marianoelia/flip-dot/3DCase/4.5mmAcrylic/Decals/FlipDotBack.png

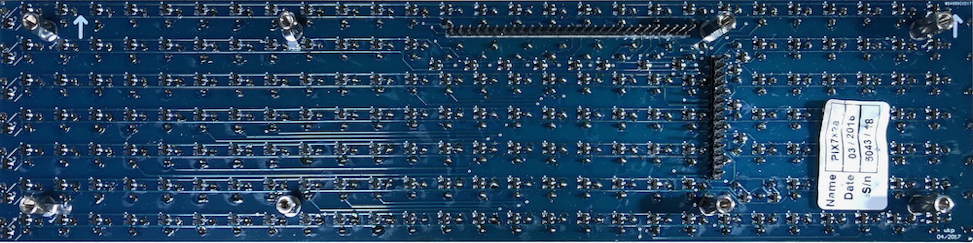
3DCase/4.5mmAcrylic/Decals/FlipDotBack.png
