marianoelia/flip-dot/3DCase/4.5mmAcrylic/Decals/PhotonTop.png

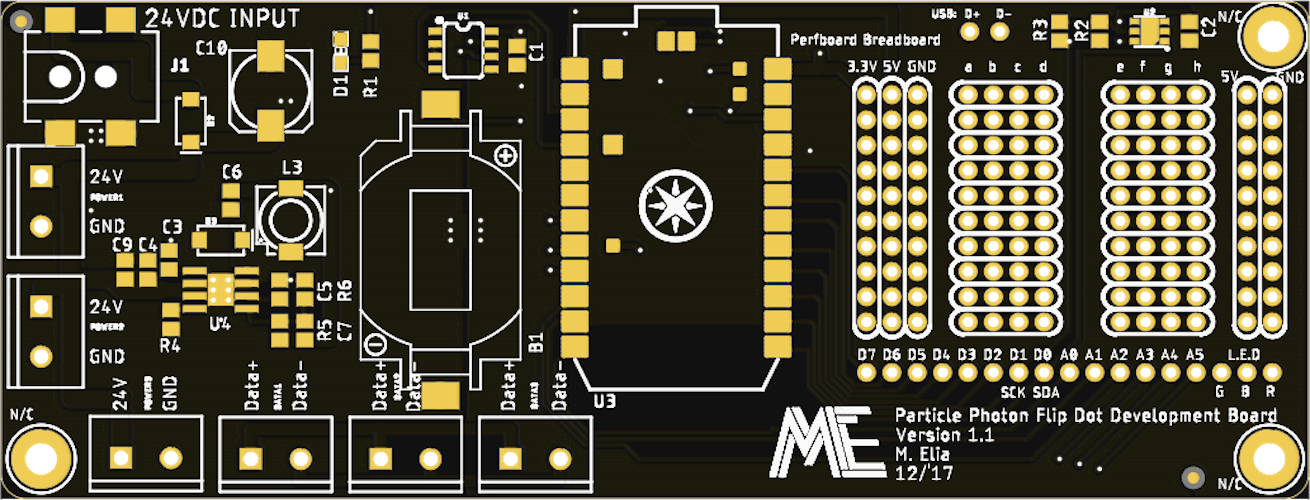
3DCase/4.5mmAcrylic/Decals/PhotonTop.png
