marianoelia/flip-dot/README.md

# Flip Dot Clock
All files for used for my flip dot display. Powered by the Particle Photon.

FlipDot
