marianoelia/flip-dot/3DCase/4.5mmAcrylic/Decals/ControllerBoard.jpg

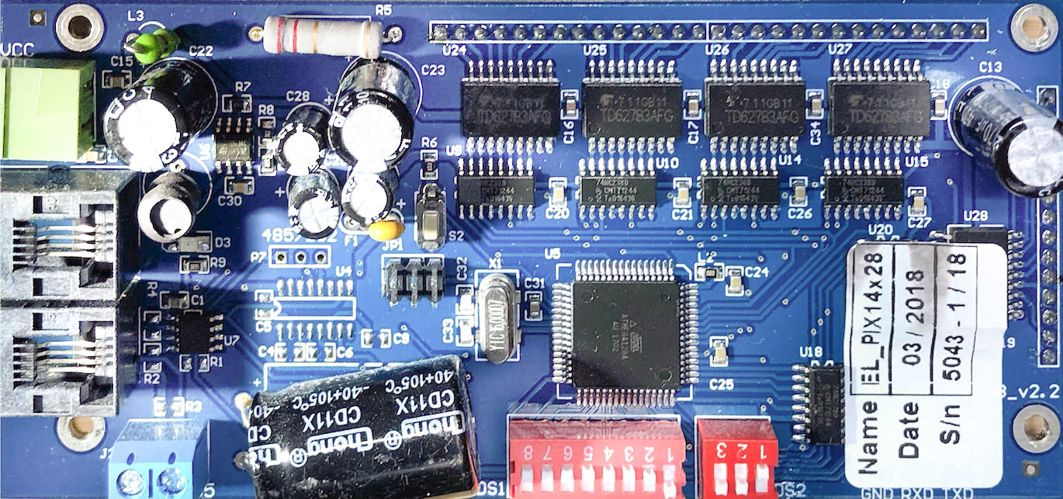
3DCase/4.5mmAcrylic/Decals/ControllerBoard.jpg
