marianoelia/flip-dot/3DCase/4.5mmAcrylic/Decals/PhotonBottom.png

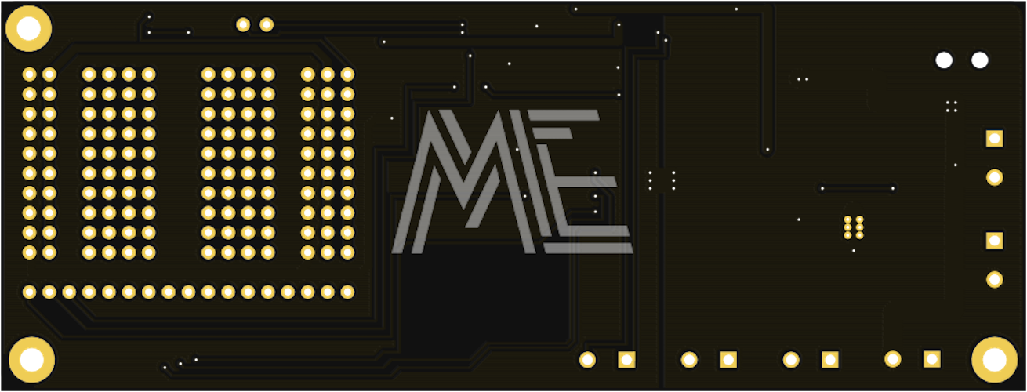
3DCase/4.5mmAcrylic/Decals/PhotonBottom.png
