marianoelia/flip-dot/3DCase/SinglePiece/SinglePieceAssembly.SLDASM

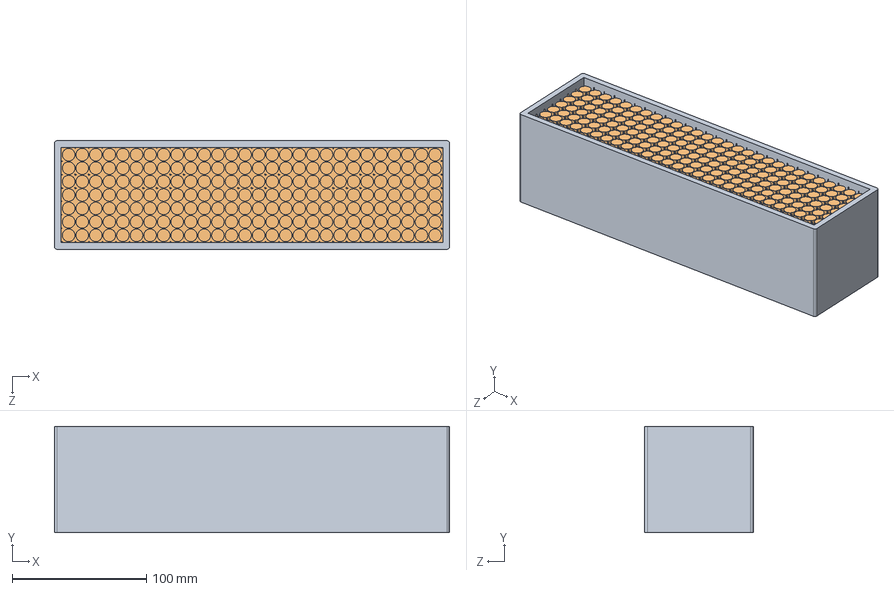
[picture p5: CAD file, 2018-06-12]
3DCase/SinglePiece/SinglePieceAssembly.SLDASM
294.0 x 79.0 x 81.0 mm
Case
Panel
