marianoelia/flip-dot/3DCase/4.5mmAcrylic/CaseAssembly4.5mm.SLDASM

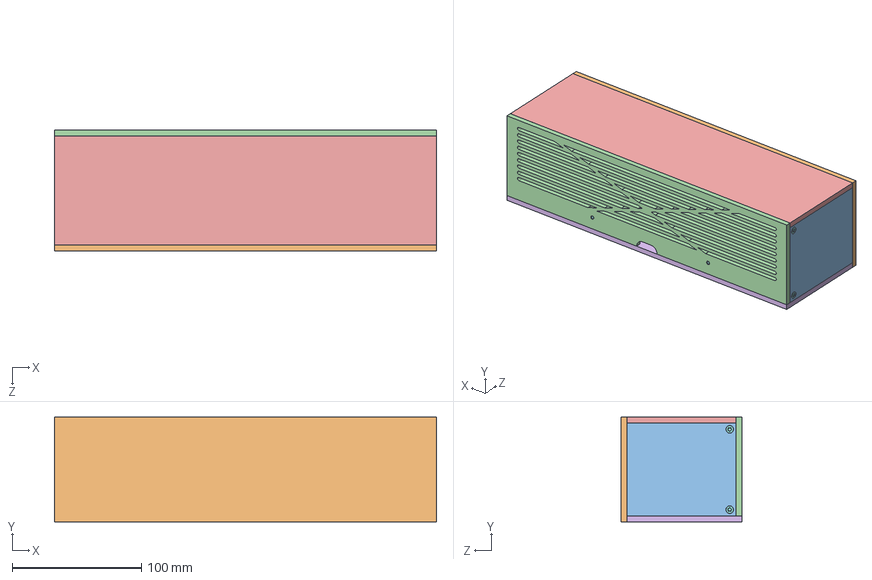
[picture p6: CAD file, 2018-11-08]
3DCase/4.5mmAcrylic/CaseAssembly4.5mm.SLDASM
295.0 x 81.0 x 93.5 mm
Panel4.5mm
FrontSide4.5mm
leftRightSides4.5mm x 2
BackSide4.5mm
TopSide4.5mm
BottomSide4.5mm
5.3mmHeatInsert x 4
M3HexScrew x 6
FlipDotControllerBoard
15mmHexStandoff x 2
PhotonPCB
20mmHexStandoff x 2
GluedInsetBlock4mm x 4
