marianoelia/flip-dot/3DCase/4.5mmAcrylic/AllPartsForLaserCutting.SLDASM

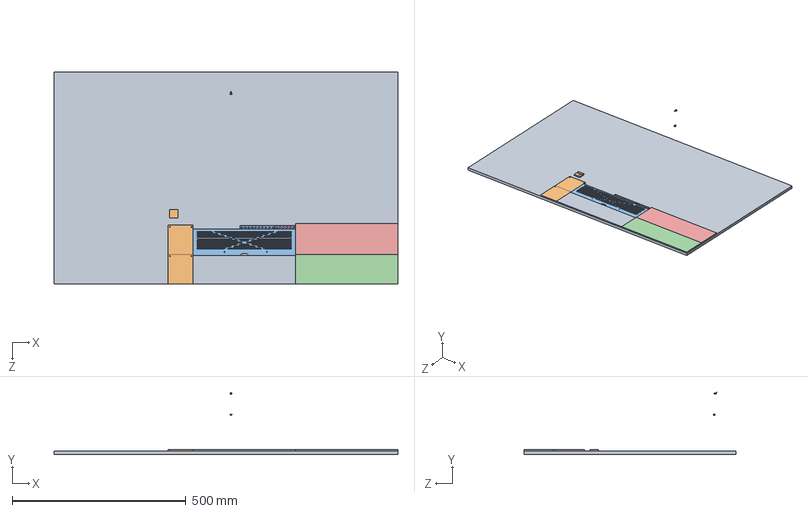
[picture p7: CAD file, 2018-11-08]
3DCase/4.5mmAcrylic/AllPartsForLaserCutting.SLDASM
990.6 x 178.6 x 609.6 mm
FrontSide4.5mm
leftRightSides4.5mm x 2
BackSide4.5mm
TopSide4.5mm
BottomSide4.5mm
GluedInsetBlock5mm x 6
1inchSquare
GluedInsetBlock4mm x 10
