marianoelia/flip-dot/3DCase/4.5mmAcrylic/1inchSquare.SLDPRT

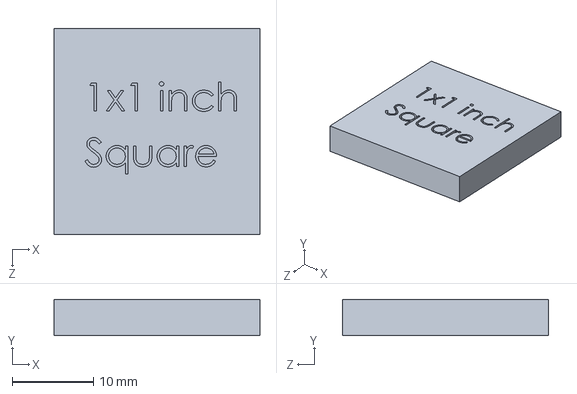
[picture p8: CAD file, 2018-11-08]
3DCase/4.5mmAcrylic/1inchSquare.SLDPRT
25.4 x 4.50 x 25.4 mm
