marianoelia/flip-dot/3DCase/4.5mmAcrylic/STLFiles/BackSide4.STL

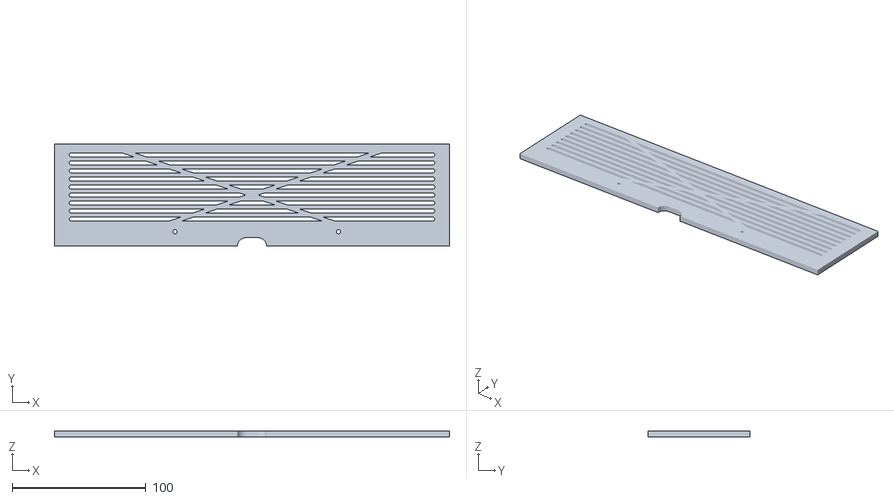
[picture p9: CAD file, 2018-11-08]
3DCase/4.5mmAcrylic/STLFiles/BackSide4.STL
295.0 x 76.5 x 4.50
