marianoelia/flip-dot/3DCase/LaserCuttingFile/4.5mmAllPartsForLaserCutting.dxf

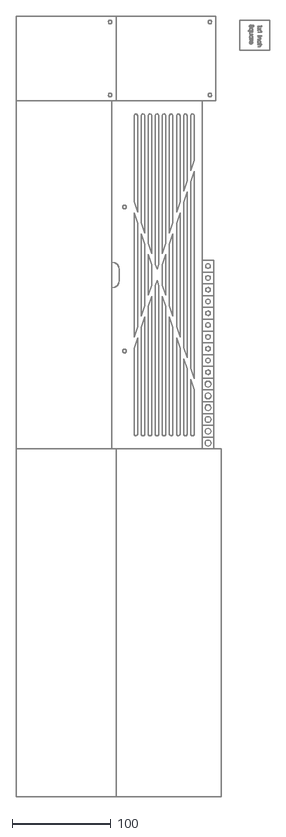
[picture p10: CAD file, 2018-11-08]
3DCase/LaserCuttingFile/4.5mmAllPartsForLaserCutting.dxf
256.9 x 792.2
