marianoelia/flip-dot/3DCase/SinglePiece/Case.SLDPRT

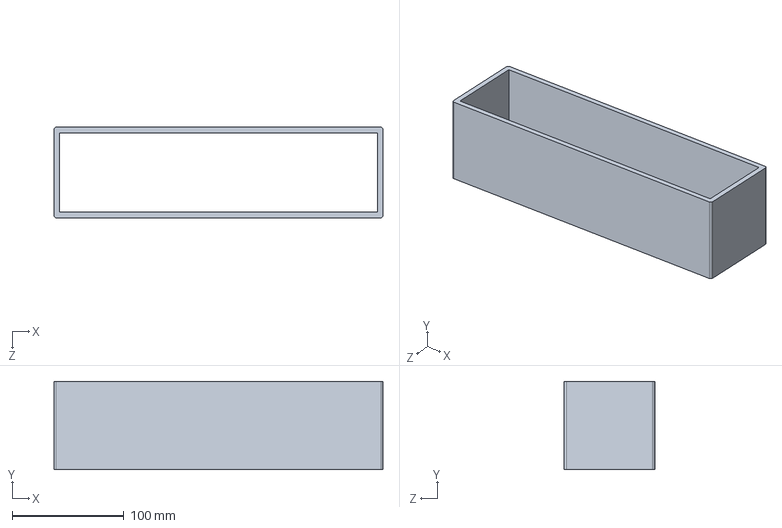
[picture p11: CAD file, 2018-06-12]
3DCase/SinglePiece/Case.SLDPRT
294.0 x 79.0 x 81.0 mm
