marianoelia/flip-dot/3DCase/4.5mmAcrylic/leftRightSides4.5mm.SLDPRT

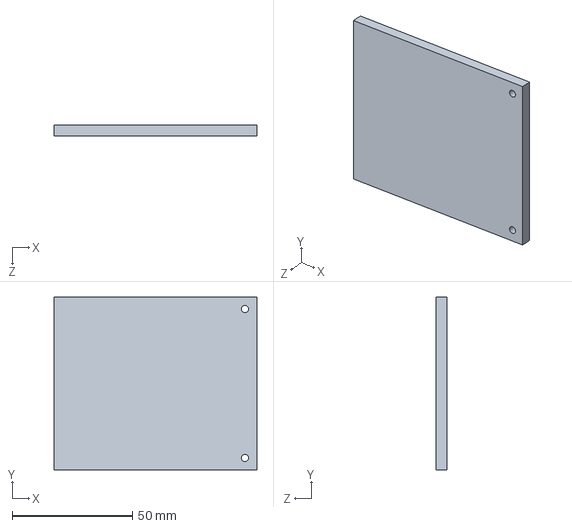
[picture p12: CAD file, 2018-11-08]
3DCase/4.5mmAcrylic/leftRightSides4.5mm.SLDPRT
84.5 x 72.0 x 4.50 mm
