marianoelia/flip-dot/3DCase/4.5mmAcrylic/4.5mmAllPartsForLaserCutting.DXF

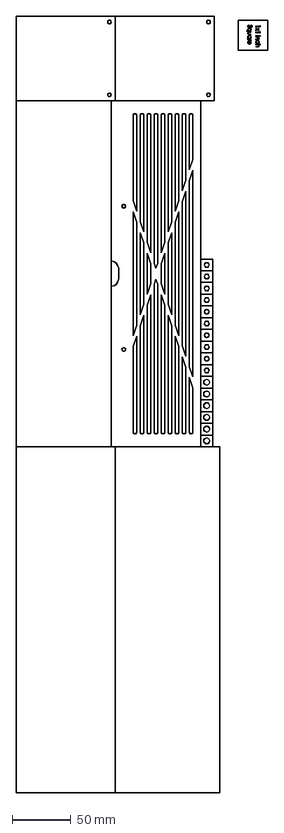
[picture p13: CAD file, 2018-11-08]
3DCase/4.5mmAcrylic/4.5mmAllPartsForLaserCutting.DXF
214.7 x 662.0 mm
