marianoelia/flip-dot/3DCase/SinglePiece/Panel.SLDPRT

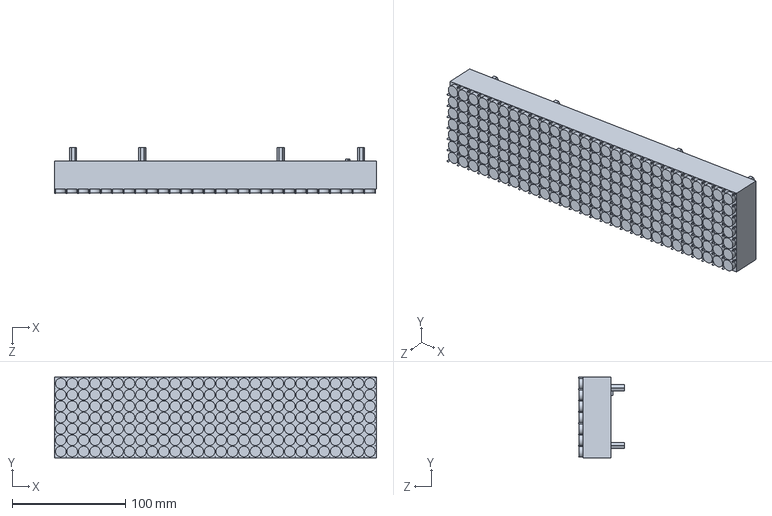
[picture p14: CAD file, 2018-06-10]
3DCase/SinglePiece/Panel.SLDPRT
284.0 x 71.0 x 40.7 mm
