marianoelia/flip-dot/3DCase/4.5mmAcrylic/4.1mmHeatInsert.SLDPRT

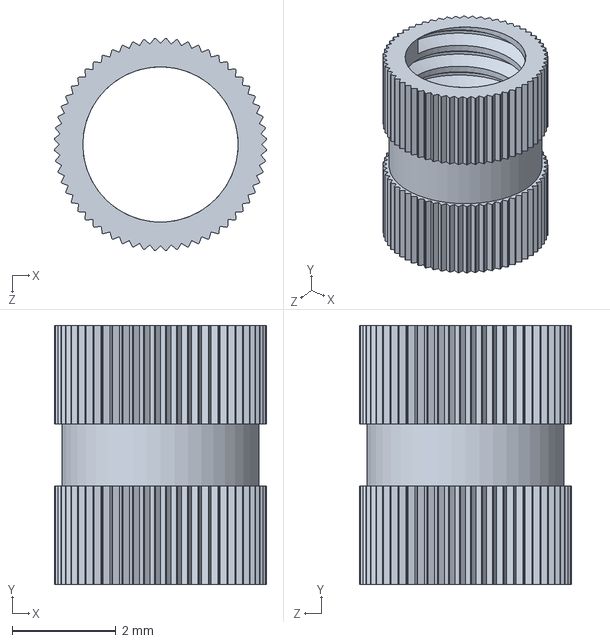
[picture p15: CAD file, 2018-11-08]
3DCase/4.5mmAcrylic/4.1mmHeatInsert.SLDPRT
4.10 x 5.00 x 4.10 mm
