marianoelia/flip-dot/3DCase/4.5mmAcrylic/GluedInsetBlock4mm.SLDPRT

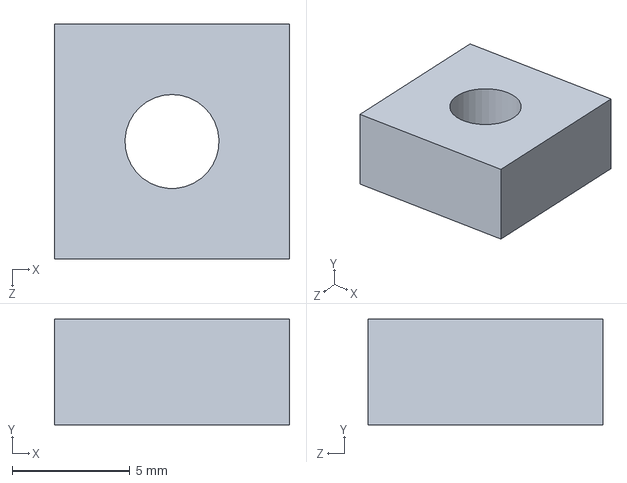
[picture p16: CAD file, 2018-11-08]
3DCase/4.5mmAcrylic/GluedInsetBlock4mm.SLDPRT
10.0 x 4.50 x 10.0 mm
