marianoelia/flip-dot/3DCase/4.5mmAcrylic/ControllerBoardToPhoton.SLDPRT

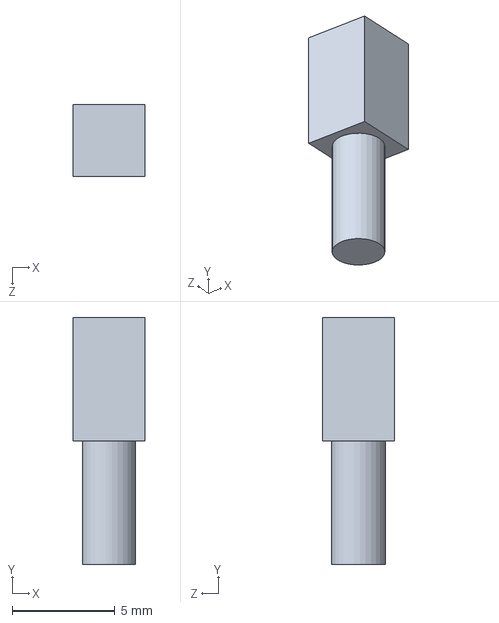
[picture p17: CAD file, 2018-06-12]
3DCase/4.5mmAcrylic/ControllerBoardToPhoton.SLDPRT
3.50 x 12.0 x 3.50 mm
