marianoelia/flip-dot/3DCase/4.5mmAcrylic/BottomSide4.5mm.SLDPRT

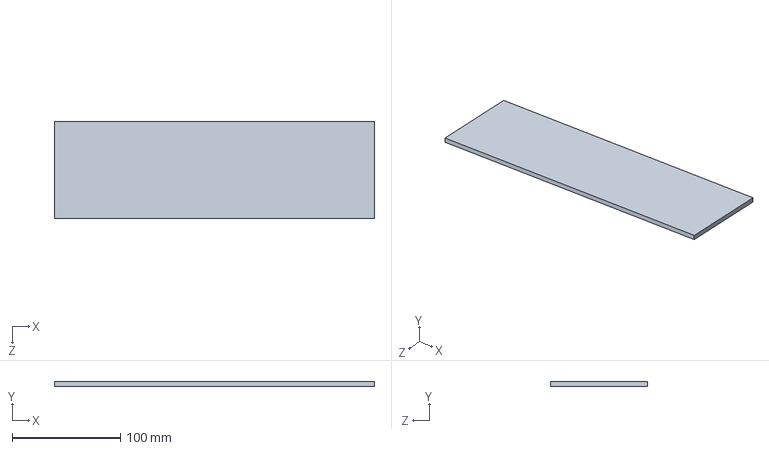
[picture p18: CAD file, 2018-06-12]
3DCase/4.5mmAcrylic/BottomSide4.5mm.SLDPRT
295.0 x 4.50 x 89.0 mm
