marianoelia/flip-dot/3DCase/4.5mmAcrylic/FrontSide4.5mm.SLDPRT

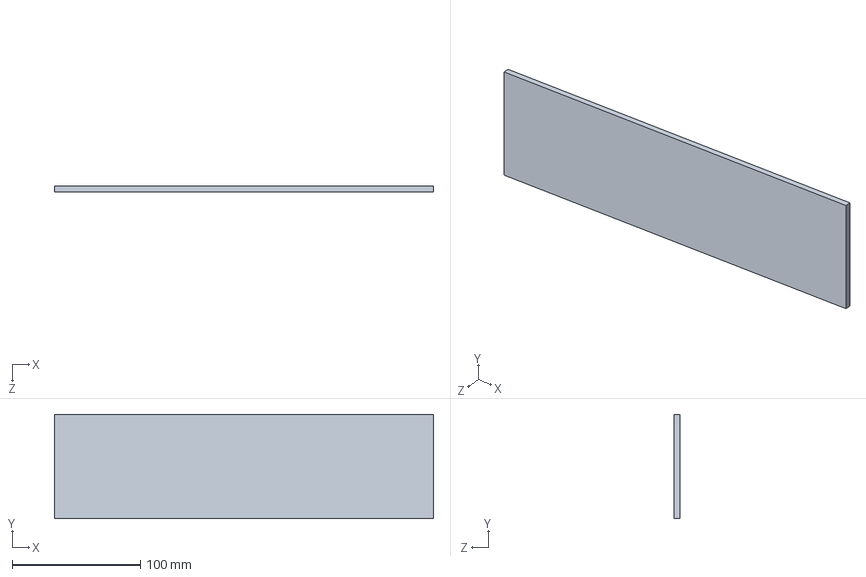
[picture p19: CAD file, 2018-06-12]
3DCase/4.5mmAcrylic/FrontSide4.5mm.SLDPRT
295.0 x 81.0 x 4.50 mm
