marianoelia/flip-dot/3DCase/4.5mmAcrylic/20mmHexStandoff.SLDPRT

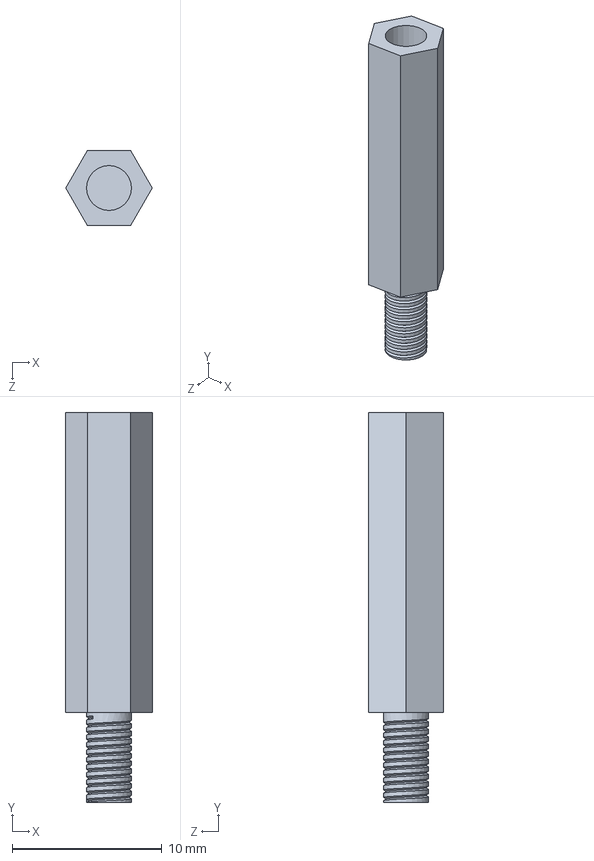
[picture p20: CAD file, 2018-06-12]
3DCase/4.5mmAcrylic/20mmHexStandoff.SLDPRT
5.77 x 26.0 x 5.00 mm
