marianoelia/flip-dot/3DCase/4.5mmAcrylic/PhotonPCB.SLDPRT

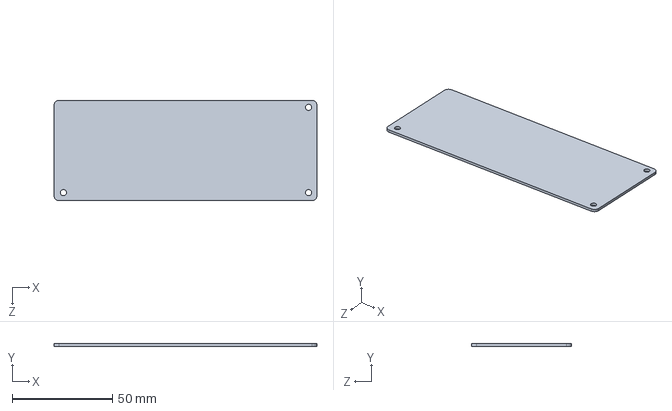
[picture p22: CAD file, 2018-06-10]
3DCase/4.5mmAcrylic/PhotonPCB.SLDPRT
131.0 x 1.30 x 50.0 mm
