marianoelia/flip-dot/3DCase/4.5mmAcrylic/15mmHexStandoff.SLDPRT

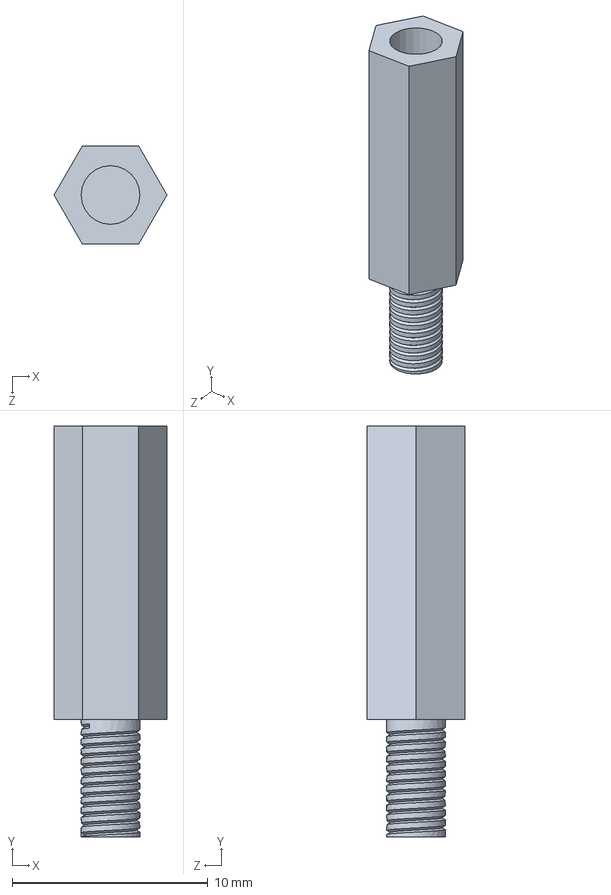
[picture p23: CAD file, 2018-06-10]
3DCase/4.5mmAcrylic/15mmHexStandoff.SLDPRT
5.77 x 21.0 x 5.00 mm
