marianoelia/flip-dot/3DCase/4.5mmAcrylic/FlipDotControllerBoard.SLDPRT

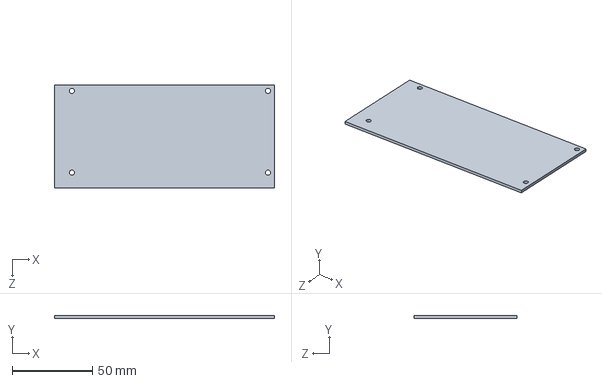
[picture p24: CAD file, 2018-06-10]
3DCase/4.5mmAcrylic/FlipDotControllerBoard.SLDPRT
137.0 x 1.80 x 64.3 mm
