marianoelia/flip-dot/3DCase/4.5mmAcrylic/96x48.SLDPRT

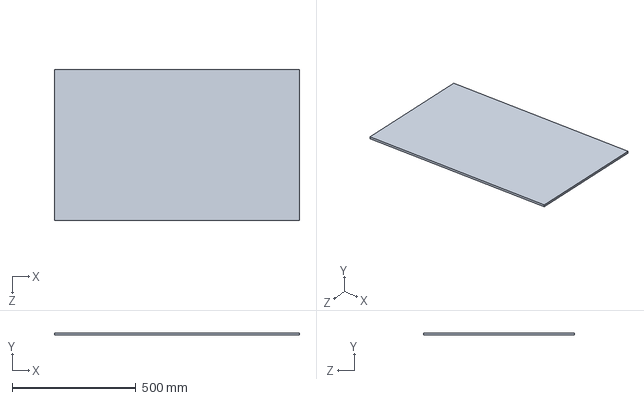
[picture p25: CAD file, 2018-06-08]
3DCase/4.5mmAcrylic/96x48.SLDPRT
990.6 x 10.0 x 609.6 mm
