marianoelia/flip-dot/3DCase/4.5mmAcrylic/5.3mmHeatInsert.SLDPRT

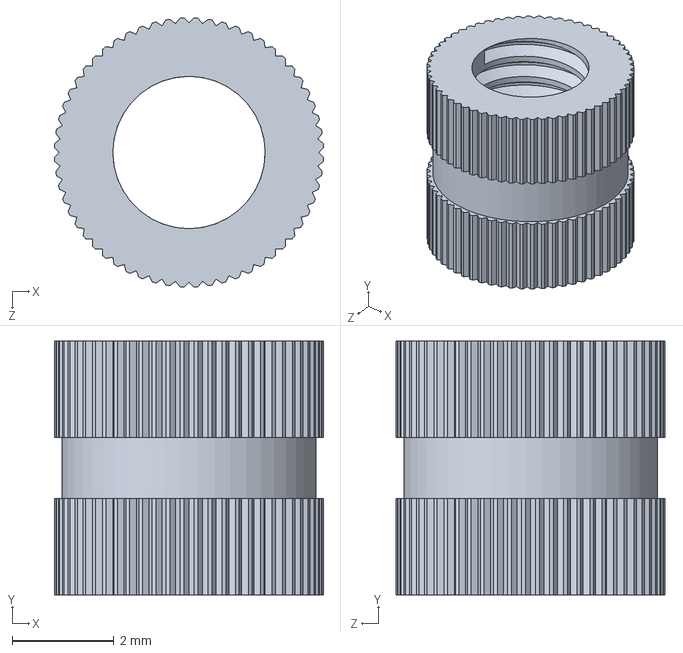
[picture p26: CAD file, 2018-06-08]
3DCase/4.5mmAcrylic/5.3mmHeatInsert.SLDPRT
5.30 x 5.00 x 5.30 mm
