marianoelia/flip-dot/3DCase/4.5mmAcrylic/StandoffPositions.SLDPRT

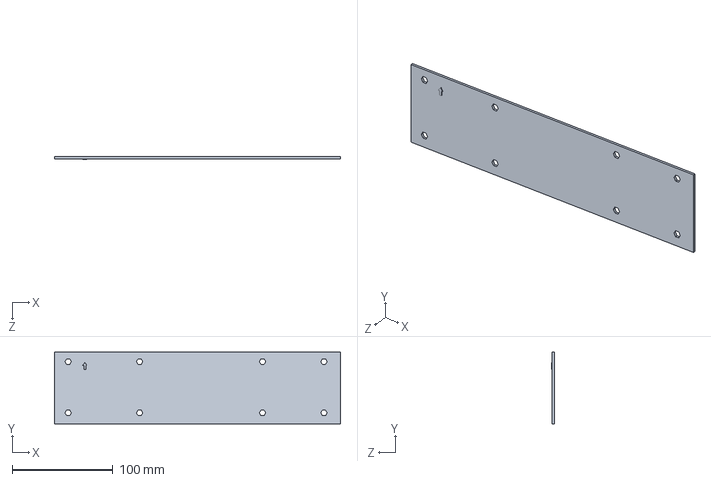
[picture p27: CAD file, 2018-06-08]
3DCase/4.5mmAcrylic/StandoffPositions.SLDPRT
284.0 x 71.0 x 2.50 mm
