marianoelia/flip-dot/(list of files, cad)

Other CAD files:
3DCase/4.5mmAcrylic/STLFiles/leftRightSides4.STL
3DCase/4.5mmAcrylic/BackSide4.5mm.SLDPRT
3DCase/4.5mmAcrylic/GluedInsetBlock5mm.SLDPRT
3DCase/4.5mmAcrylic/AllPartsForLaserCutting.SLDDRW
3DCase/4.5mmAcrylic/GluedInsetBlock4mm.STL
3DCase/4.5mmAcrylic/GluedInsetBlock5mm.STL
3DCase/4.5mmAcrylic/M3HexScrew.SLDPRT
3DCase/4.5mmAcrylic/Panel4.5mm.SLDDRW
3DCase/4.5mmAcrylic/STLFiles/BackSide4.5mm.STL
3DCase/4.5mmAcrylic/STLFiles/BottomSide4.5mm.STL
3DCase/4.5mmAcrylic/STLFiles/FrontSide4.5mm.STL
3DCase/4.5mmAcrylic/STLFiles/StandoffPositions.STL
3DCase/4.5mmAcrylic/STLFiles/TopSide4.5mm.STL
3DCase/4.5mmAcrylic/STLFiles/leftRightSides4.5mm.STL
