marianoelia/flip-dot/PCB/board1.sch

## EAGLE design PCB/board1.sch (2018-06-08)

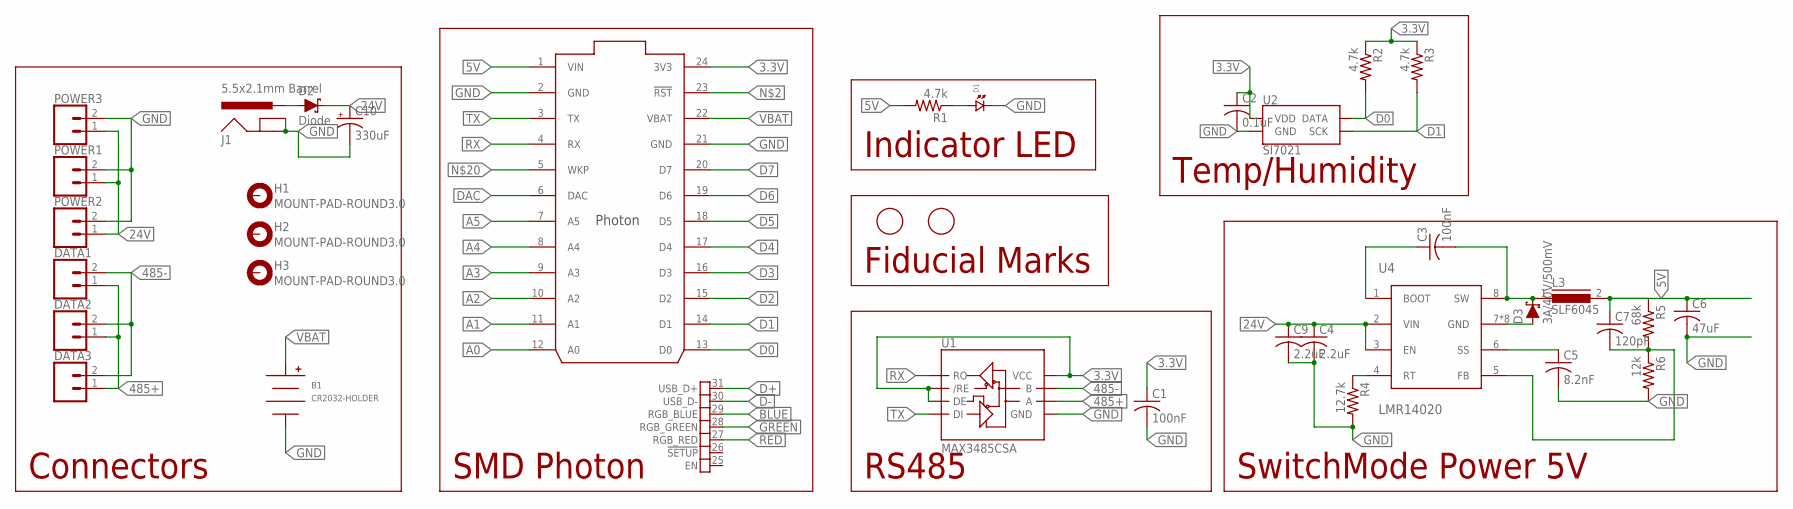
[picture p28: schematic board1.sch]

Parts:
B1: CR2032-HOLDER; CH28-2032LF
C1, C3: 100nF; C0805
C2: 0.1uF; C0805
C4, C9: 2.2uF; C0805
C5: 8.2nF; C0805
C6: 47uF; C0805
C7: 120pF; C0805
C10: 330uF; 175TMP-0808
D1: LED.0805; 0805.LED
D2: Diode; SMA-DIODE
D3: 3A/40V/500mV; SMA-DIODE
DATA1, DATA2, DATA3: CONN_025MM; SCREWTERMINAL-5MM-2
FID1, FID2: FIDUCIAL; FIDUCIAL_1MM
H1, H2, H3: MOUNT-PAD-ROUND3.0; 3,0-PAD
J1: 5.5x2.1mm Barrel; POWER_JACK_SMD
L3: SLF6045; SLF7045
POWER1, POWER2, POWER3: CONN_025MM; SCREWTERMINAL-5MM-2
R1, R2, R3: 4.7k; R0805
R4: 12.7k; R0805
R5: 68k; R0805
R6: 12k; R0805
U1: MAX3485CSA; SO08
U2: SI7021; DFN-6-3X3-SI7021
U3: PHOTON; PHOTON_SMD
U4: LMR14020; SOIC8

Connections:
3.3V: C1.1, C2.1, R2.1, R3.1, U1.2 (/RE), U1.3 (DE), U1.8 (VCC), U2.VDD, U3.24 (3V3)
5V: C6.1, C7.1, L3.2, R1.2, R5.1, U3.1 (VIN)
24V: C4.1, C9.1, C10.+, D2.C, POWER1.1, POWER2.1, POWER3.1, U4.2 (VIN), U4.3 (EN)
485+: DATA1.1, DATA2.1, DATA3.1, U1.6 (A)
485-: DATA1.2, DATA2.2, DATA3.2, U1.7 (B)
A0: U3.12 (A0)
A1: U3.11 (A1)
A2: U3.10 (A2)
A3: U3.9 (A3)
A4: U3.8 (A4)
A5: U3.7 (A5)
BLUE: U3.29 (RGB_BLUE)
D0: R2.2, U2.DATA, U3.13 (D0)
D1: R3.2, U2.SCK, U3.14 (D1)
D2: U3.15 (D2)
D3: U3.16 (D3)
D4: U3.17 (D4)
D5: U3.18 (D5)
D6: U3.19 (D6)
D7: U3.20 (D7)
D+: U3.31 (USB_D+)
D-: U3.30 (USB_D-)
DAC: U3.6 (DAC)
FB: C7.2, R5.2, R6.1, U4.5 (FB)
GND: B1.NEG, C1.2, C2.2, C4.2, C5.2, C6.2, C9.2, C10.-, D1.P$2 (2), D3.A, J1.GND (GNDBREAK), J1.P$4 (GND), POWER1.2, POWER2.2, POWER3.2, R4.2, R6.2, U1.5 (GND), U2.GND, U3.2 (GND), U3.21 (GND), U4.7 (GND)
GREEN: U3.28 (RGB_GREEN)
unnamed: D1.P$1 (1), R1.1
unnamed: C3.1, U4.1 (BOOT)
unnamed: R4.1, U4.4 (RT)
unnamed: C5.1, U4.6 (SS)
RED: U3.27 (RGB_RED)
RX: U1.1 (RO), U3.4 (RX)
SW: C3.2, D3.C, L3.1, U4.8 (SW)
TX: U1.4 (DI), U3.3 (TX)
VBAT: B1.POS, U3.22 (VBAT)
VIN: D2.A, J1.VIN0 (PWR)

Notes on the sheet:
Connectors
RS485
Fiducial Marks
Indicator LED
Temp/Humidity
SwitchMode Power 5V
SMD Photon
