marianoelia/flip-dot/(commit log)

2018-06-08 Added eagle files
    [board1.sch]
2018-06-08 Added solidworks files
    [1inchSquare.SLDPRT, 5.3mmHeatInsert.SLDPRT, 96x48.SLDPRT, AllPartsFlipDotDXF.DXF, AllPartsForLaserCutting.SLDASM, AllPartsForLaserCutting.SLDDRW, BackSide4.5mm.SLDPRT, BottomSide4.5mm.SLDPRT]
2018-06-09 Changes to standoff position
    [Panel4.5mm.SLDDRW]
2018-06-10 Changes to PCB
    [15mmHexStandoff.SLDPRT, CaseAssembly4.5mm.SLDASM, FlipDotControllerBoard.SLDPRT, Panel4.5mm.SLDDRW, Panel4.5mm.SLDPRT, PhotonPCB.SLDPRT]
2018-06-10 updated case
    [CaseAssembly4.5mm.SLDASM]
2018-06-12 Updated solidworks
    [20mmHexStandoff.SLDPRT, BackSide4.5mm.SLDPRT, BackSide4.5mm.STL, BottomSide4.5mm.SLDPRT, BottomSide4.5mm.STL, Case.SLDPRT, CaseAssembly4.5mm.SLDASM, ControllerBoardToPhoton.SLDPRT]
2018-11-08 Send in 3D case files to be laser cut
    [1inchSquare.SLDPRT, 4.1mmHeatInsert.SLDPRT, 4.5mmAllPartsForLaserCutting.DXF, 4.5mmAllPartsForLaserCutting.dxf, AllPartsFlipDotDXF.DXF, AllPartsForLaserCutting.SLDASM, AllPartsForLaserCutting.SLDDRW, BackSide4.5mm.SLDPRT]
2018-11-08 updated pcb
